jwkunz/BYU7SegBoard/AltiumFiles/Board Picture.PNG

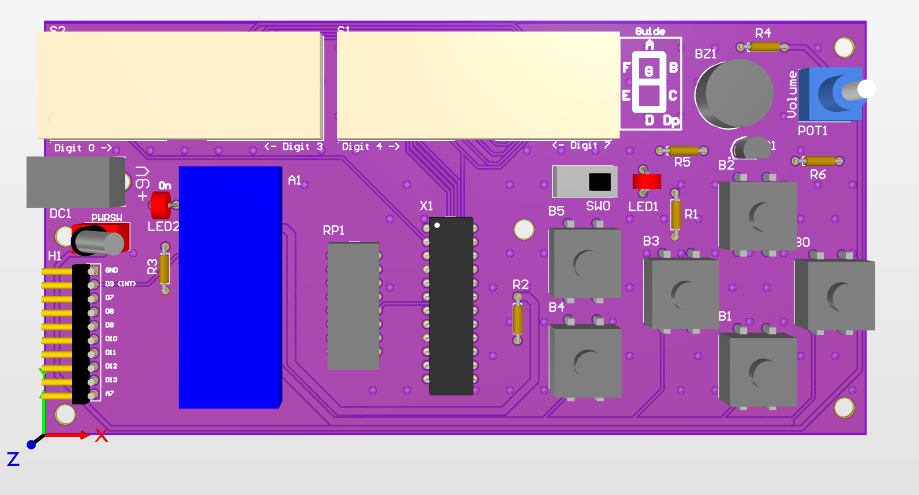
AltiumFiles/Board Picture.PNG
