jwkunz/BYU7SegBoard/Documentation/ArduinoInterfaceGraphic.PNG

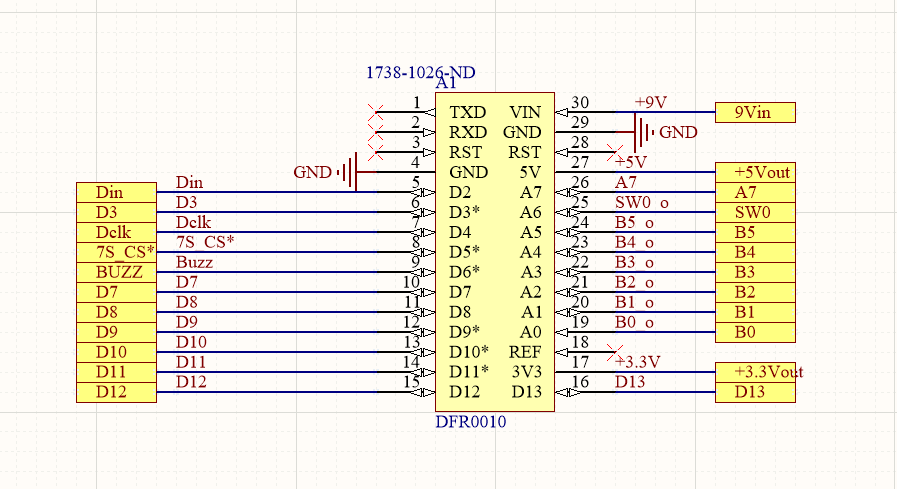
Documentation/ArduinoInterfaceGraphic.PNG
