jwkunz/BYU7SegBoard/Documentation/CostTable.pdf

### Seven Segment Board

Price Break | | Purchased For August 8th Activity
Component | Vendor | | 1 | 3 | 6 | 10 | 50 | 100 | 4
Fabrication | OSH PARK | 97.95 $ | 97.95 $ | 182.50 $ | 182.50 $ | 912.50 $ | 1,825.00 $ | 97.95 $ | *Given Free Board from QuickTurn
Board Parts | Mouser | 50.97 $ | 136.93 $ | 265.87 $ | 437.79 $ | 1,941.29 $ | 3,444.79 $ | 179.91 $
Arduino Nano | Amazon | 8.29 $ | 13.86 $ | 27.72 $ | 37.98 $ | 189.90 $ | 379.80 $ | 31.98 $
Shop Supplies | ECEN Shop | 2.00 $ | 2.00 $ | 2.00 $ | 4.00 $ | 6.00 $ | 10.00 $ | 2.00 $
Total | 160.21 $ | 253.74 $ | 484.09 $ | 672.27 $ | 3,099.69 $ | 5,759.59 $ | 315.84 $
Cost Per | 160.21 $ | 84.58 $ | 80.68 $ | 67.23 $ | 61.99 $ | 57.60 $ | 78.96 $
