jwkunz/BYU7SegBoard/Documentation/MouserBOM.pdf

SHOPPING CART
This is not an invoice
23-Jul-18 14:51:10
Mouser # | Mfr. # | Manufacturer | Customer # Description | RoHS | Lifecycle | Order Qty. Price (USD) | Ext.: (USD)
1 474-COM-09190 | COM-09190 | SparkFun Electronics | SparkFun Accessories Momentary Pushbutton Switch - 12mm Square RoHS Compliant | New At Mouser | 6 $0.50 | $3.00
2 810-PS1240P02BT | PS1240P02BT | TDK | Audio Indicators & Alerts Round 12.2mmx6.5mm 4kHz Vin=3V | RoHS Compliant | | 1 $0.72 | $0.72
3 490-PJ-037A | PJ-037A | CUI Inc. | DC Power Connectors Power Jacks | RoHS Compliant | | 1 $0.58 | $0.58
4 859-LTL-4223 | LTL-4223 | Lite-On | Standard LEDs - Through Hole Red Diffused | RoHS Compliant | | 2 $0.12 | $0.24
5 652-3310R-125-103L | 3310R-125-103L | Bourns | Potentiometers 9mm 10Kohms Single Cup | RoHS Compliant | | 1 $2.61 | $2.61
6 612-200-A1121 | 200MSP1T1B1M2QEH E-Switch | Toggle Switches SPDT ON-OFF-ON PCMNT | RoHS Compliant | 1 $2.23 | $2.23
7 512-2N3904BU | 2N3904BU | ON Semiconductor | Bipolar Transistors - BJT NPN Transistor General Purpose | RoHS Compliant | | 1 $0.21 | $0.21
8 603-MFR-25FBF52-9K53 MFR-25FBF52-9K53 | Yageo | Metal Film Resistors - Through Hole 9.53K OHM 1/4W 1% | RoHS Compliant | 1 $0.12 | $0.12
9 652-4116R-2LF-10K | 4116R-2-103LF | Bourns | Resistor Networks & Arrays 16pin 10Kohms Bussed Low Profile | RoHS Compliant By Exemption | | 1 $1.09 | $1.09
10 696-LDQ-N516RI | LDQ-N516RI | Lumex | LED Displays & Accessories .56" SUPER RED | RoHS Compliant | | 2 $6.73 | $13.46
11 642-SLG12014 | SLG12014 | Apem | Slide Switches SLIDE 1P2T | RoHS Compliant | | 1 $1.46 | $1.46
12 700-MAX7219CNG | MAX7219CNG+ | Maxim Integrated | LED Display Drivers 8-Digit LED Display Driver | RoHS Compliant | | 1 $9.12 | $9.12
13 474-TOL-00298 | TOL-00298 | SparkFun Electronics | SparkFun Accessories Wall Adapter Power Supply - 9VDC 650mA | | New At Mouser | 1 $5.95 | $5.95
14 603-MFR-25FRF52100R MFR-25FRF52-100R | Yageo | Metal Film Resistors - Through Hole 100ohm 1/4W 1% | RoHS Compliant By Exemption | 2 $0.12 | $0.24
15 603-MFR-25FTF52-1K | MFR-25FTF52-1K | Yageo | Metal Film Resistors - Through Hole 1/4W 1K Ohm 1% | RoHS Compliant | New Product | 2 $0.12 | $0.24
16 603-MFR-25FBF52-18R MFR-25FBF52-18R | Yageo | Metal Film Resistors - Through Hole 18 OHM 1/4W 1% | RoHS Compliant | 1 $0.12 | $0.12
17 538-90121-0768 | 90121-0768 | Molex | Headers & Wire Housings 2.54MM CGRIDIII HDR 8P R/A SR SEL AU | RoHS Compliant | | 1 $1.59 | $1.59
By submitting your order you agree to these terms and conditions. | Merchandise Total: | $42.98
Prices are reflected at the date and time shown. | Shipping Charge: | $7.99
