jwkunz/BYU7SegBoard/AltiumFiles/Project Outputs for BYU7SegBoard/BrendonsBoardBOM.xlsx

Part Number | Description | Designator | Supplier | Quantity | Total Cost | Purpose | Link
DFR0010 | DFRDUINO NANO V3.1 (ARDUINO NANO | A1 | Amazon | 1 | $4.00 | Control | https://www.amazon.com/ATmega328P-Microcontroller-Board-Cable-Arduino/dp/B00NLAMS9C?s=electronics
COM-09190 | Tactile Pushbotton | B0, B1, B2, B3, B4, B5 | Mouser | 6 | $3.00 | Buttons
PS1240P02BT | Piezo Buzzer, Through Hole | BZ1 | Mouser | 1 | $0.67 | Sound
PJ-037A | CONN PWR JACK 2X5.5MM SOLDER | DC1 | Mouser | 1 | $0.58 | Power
90121-0768 | Header 12 Right Angle 100 mil | H1 | Mouser | 1 | $0.50 | External Connections
LTL-4223 | 2 V drop 10 mA Red | LED1, LED2 | Mouser | 2 | $0.72 | Indicator Lights
3310R-125-103L | POT 10K OHM 1/4W PLASTIC LINEAR | POT1 | Mouser | 1 | $2.74 | Volume Control
200MSP1T1B1M2QEH | SWITCH TOGGLE SPDT 3A 120V | PWRSW | Mouser | 1 | $2.23 | Power Switch
2N3904BU | TRANS NPN 40V 0.2A TO-92 | Q1 | Mouser | 1 | $0.21 | Sound
MFR-25FRF52-100R | 100 | R1 | Mouser | 1 | $0.10 | Indicator
MFR-25FBF52-9K53 | 9.53k | R2 | Mouser | 1 | $0.10 | Display
MFR-25FTF52-1K | 1k | R3 | Mouser | 1 | $0.10 | Indicator
MFR-25FTF52-1K | 1k | R4 | Mouser | 1 | $0.10 | Volume
MFR-25FRF52-100R | 100 | R5 | Mouser | 1 | $0.10 | Volume
MFR-25FBF52-18R | 18 | R6 | Mouser | 1 | $0.10 | Sound
4116R-2-103LF | Resistor Pack | RP1 | Mouser | 1 | $1.16 | Control
LDQ-N516RI | LED 7-SEG .56 QUAD S-RED CC MULT | S1, S2 | Mouser | 2 | $13.46 | Display (1 Minimum)
SLG12014 | SWITCH SLIDE SPDT 300MA 125V | SW0 | Mouser | 1 | $1.34 | I/O Switch
MAX7219CNG+ | Serially Interfaced, 8-Digit LED Display Driver | X1 | Mouser | 1 | $8.93 | Display
RM3X10MM 2701 | M3 Machine Screws |  | Mouser | 5 | $2.70 | Mounting
 | Breadboad Wire |  | ECEN SHOP |  | $0.50 | Bypassing Parts Extra Parts
TOL-00298 | AC/DC WALL MOUNT ADAPTER 9V 650 mA |  | Mouser | 1 | $5.95 | Power
 |  |  |  | Total | $49.29
OSH PARK FAB |  |  | OSH PARK |  | $33.00
 |  |  |  |  | $82.29
 |  |  |  | Total | $82.29
 |  |  |  |  | Basic
