jwkunz/BYU7SegBoard/AltiumFiles/BYU7SegBoard.pdf

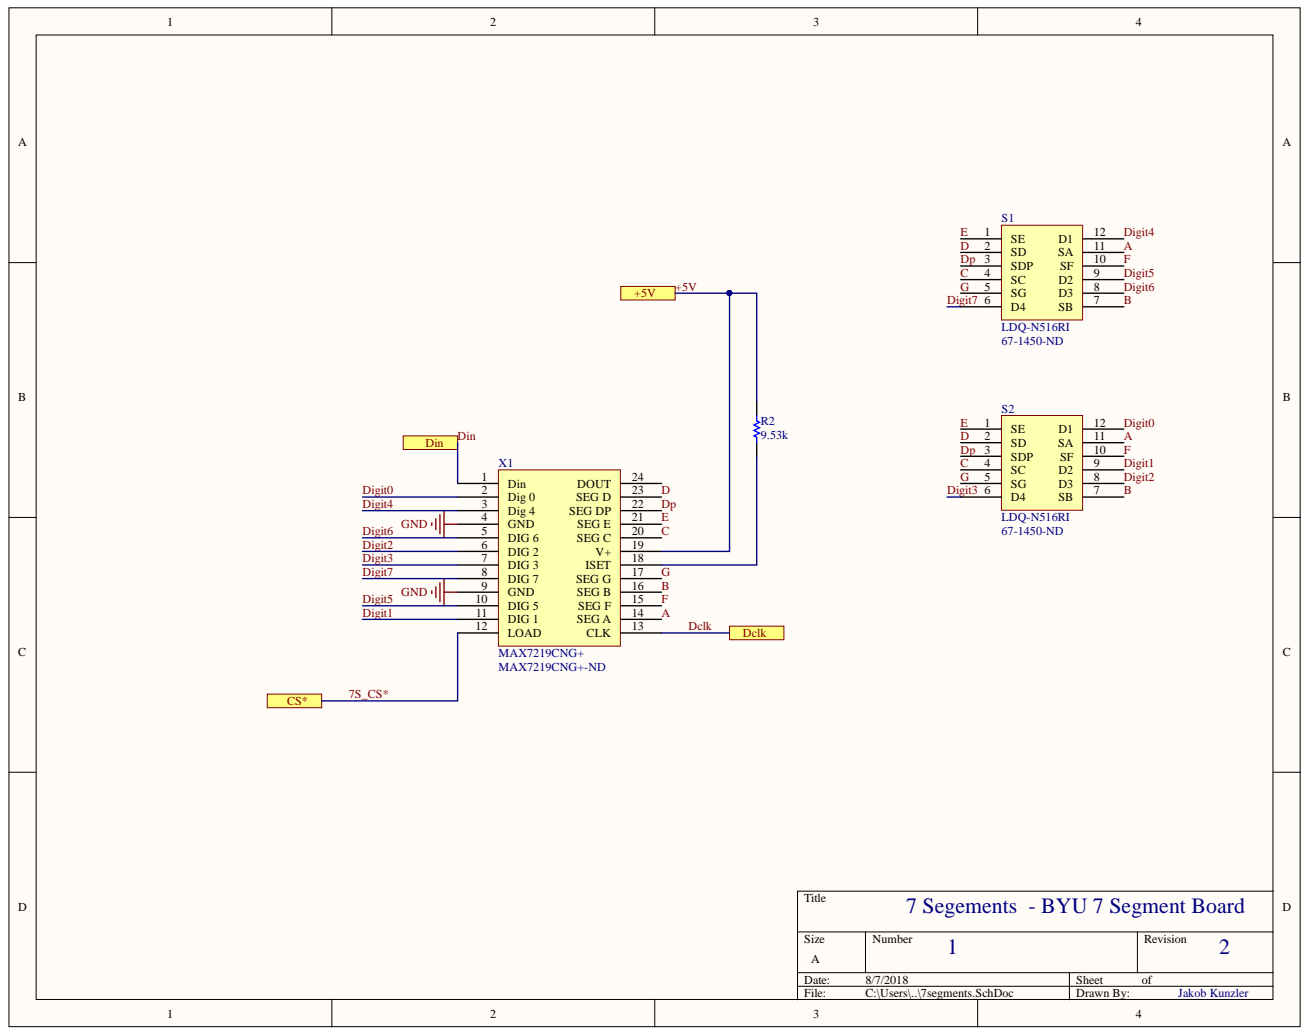
[picture p3: page 1]
Title; Size; Number; Revision; Date:; Sheet; File:; C:\Users\..\7segments.SchDoc; Drawn By:; MAX7219CNG+-ND; Din 1 Dig 0 2 Dig 4 3 GND 4 DIG 6 5 DIG 2 6 DIG 3 7 DIG 7 8 GND 9 DIG 5 10 DIG 1 11; LOAD 12; CLK; 13 SEG A; 14 SEG F; 15 SEG B; 16 SEG G; 17 ISET; 19 SEG C; 20 SEG E; 21 SEG DP; 22 SEG D; 23 DOUT; MAX7219CNG+; Din; Dclk; Digit1; Digit5; Digit7; Digit3; Digit2; Digit6; Digit4; Digit0; GND; SE 1 SD 2 SDP 3 SC 4 SG 5; LDQ-N516RI; A F Digit5 Digit6; A F Digit1 Digit2; Jakob Kunzler

7 Segements - BYU 7 Segment Board

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
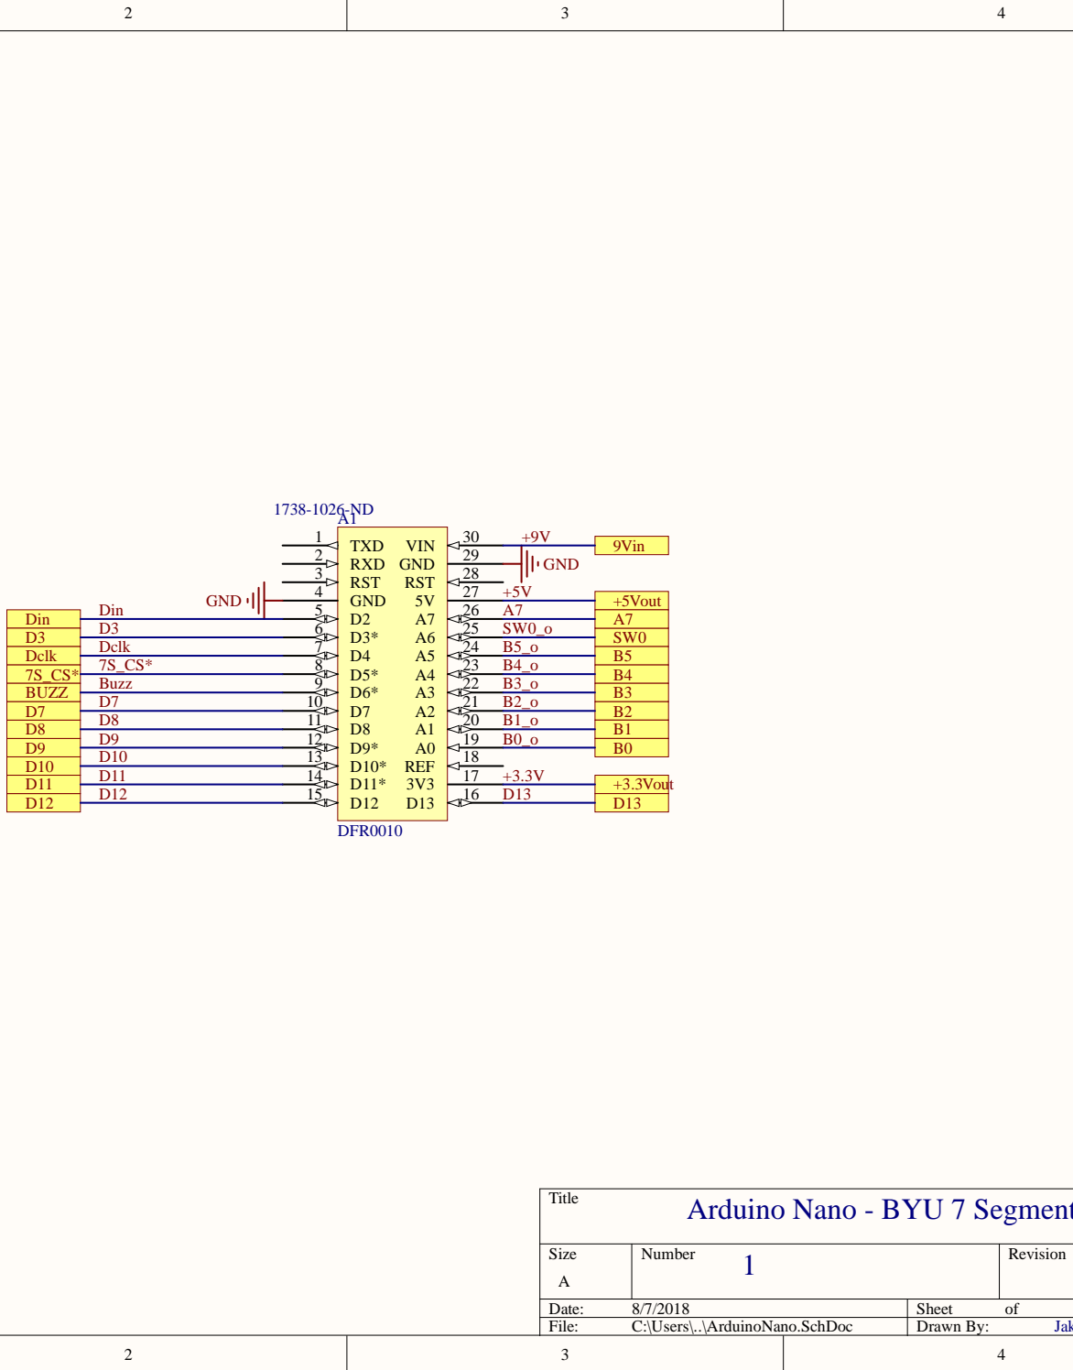
[picture p4: figure]
Numbe; Revi; ion; ADat; She; ers; ArduinoN; ano.; chDoc; Dra; Buz; +3.3Vout; +5Vout A7; PIA101 PIA102 PIA103 PIA104 PIA105 PIA106 PIA107 PIA108 PIA109 PIA1010 PIA1011 PIA1012 PIA1013; PIA1014; PIA1015; PIA1016; PIA1017; PIA1018; PIA1019; PIA1020; PIA1021; PIA1022; PIA1023; PIA1024; PIA1025; PIA1026; PIA1027; PIA1028; PIA1029; PIA1030; COA1; PO0303Vout; PO05Vout; PO9Vin; POA7; POB0; POB1; POB2; POB3; POB4; POB5; POBUZZ; POD3; POD7 POD8 POD9 POD10 POD11; POD12; POD13; PODclk; PODin; POSW0

D13 | 16 3V3 | 17 REF | 18 A0 | 19 A1 | 20 A2 | 21 A3 | 22 A4 | 23 A5 | 24 A6 | 25 A7 | 26 5V | 27 RST | 28 GND | 29 VIN | 30
Arduino Nano - BYU 7 Segment Board 1 | 2 Jakob Kunzler

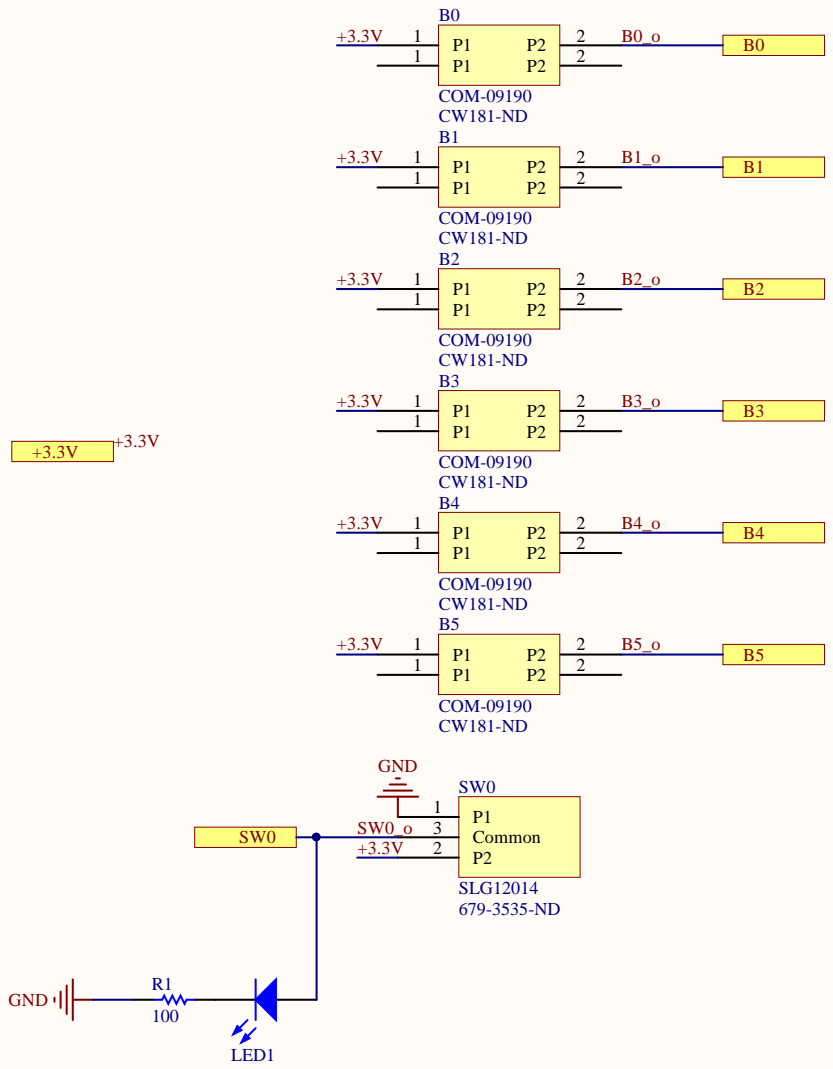
[picture p5: page 3]
Size; Number; Revision; File:; C:\Users\..\ButtonAndSwitches.SchDoc; Drawn By:; Common 3; SLG12014; GND; LED1; COM-09190

Title
Buttons and Switches - BYU 7 Segment Board

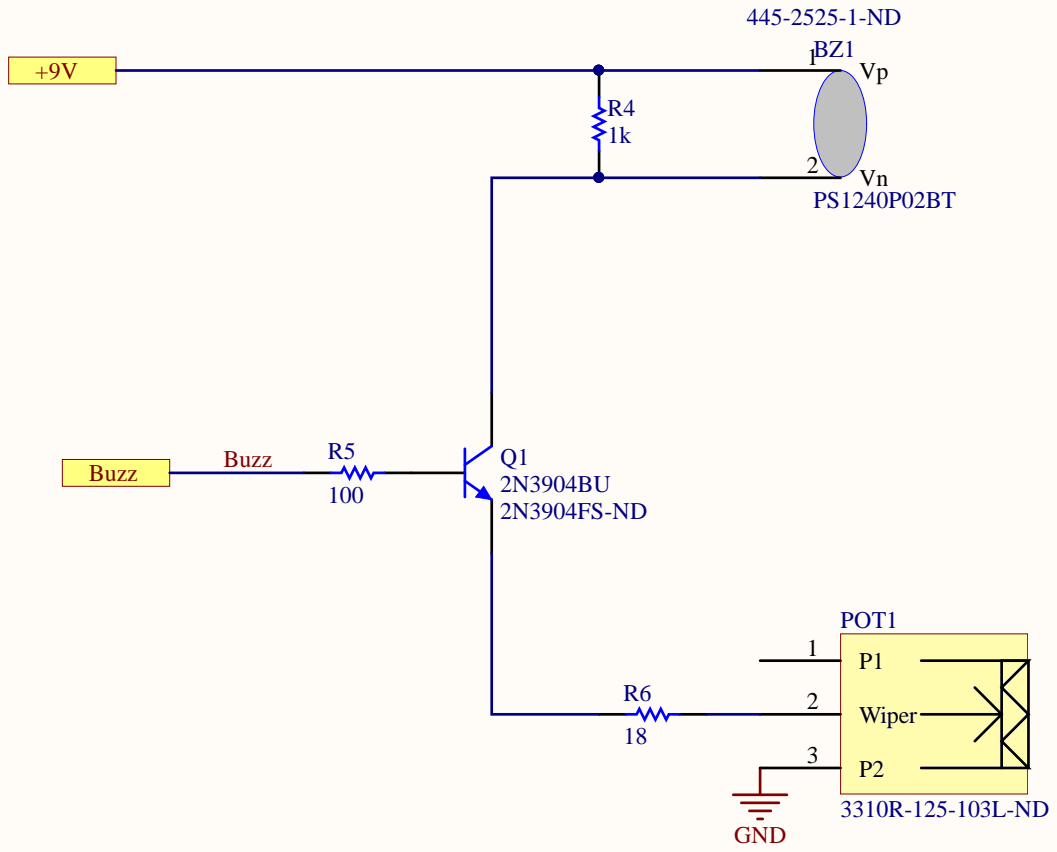
[picture p6: page 4]
Title; Size; Number; Revision; File:; C:\Users\..\Sound.SchDoc; Drawn By:; GND; Wiper 2; POT1; Buzz

Sound - BYU 7 Segment Board

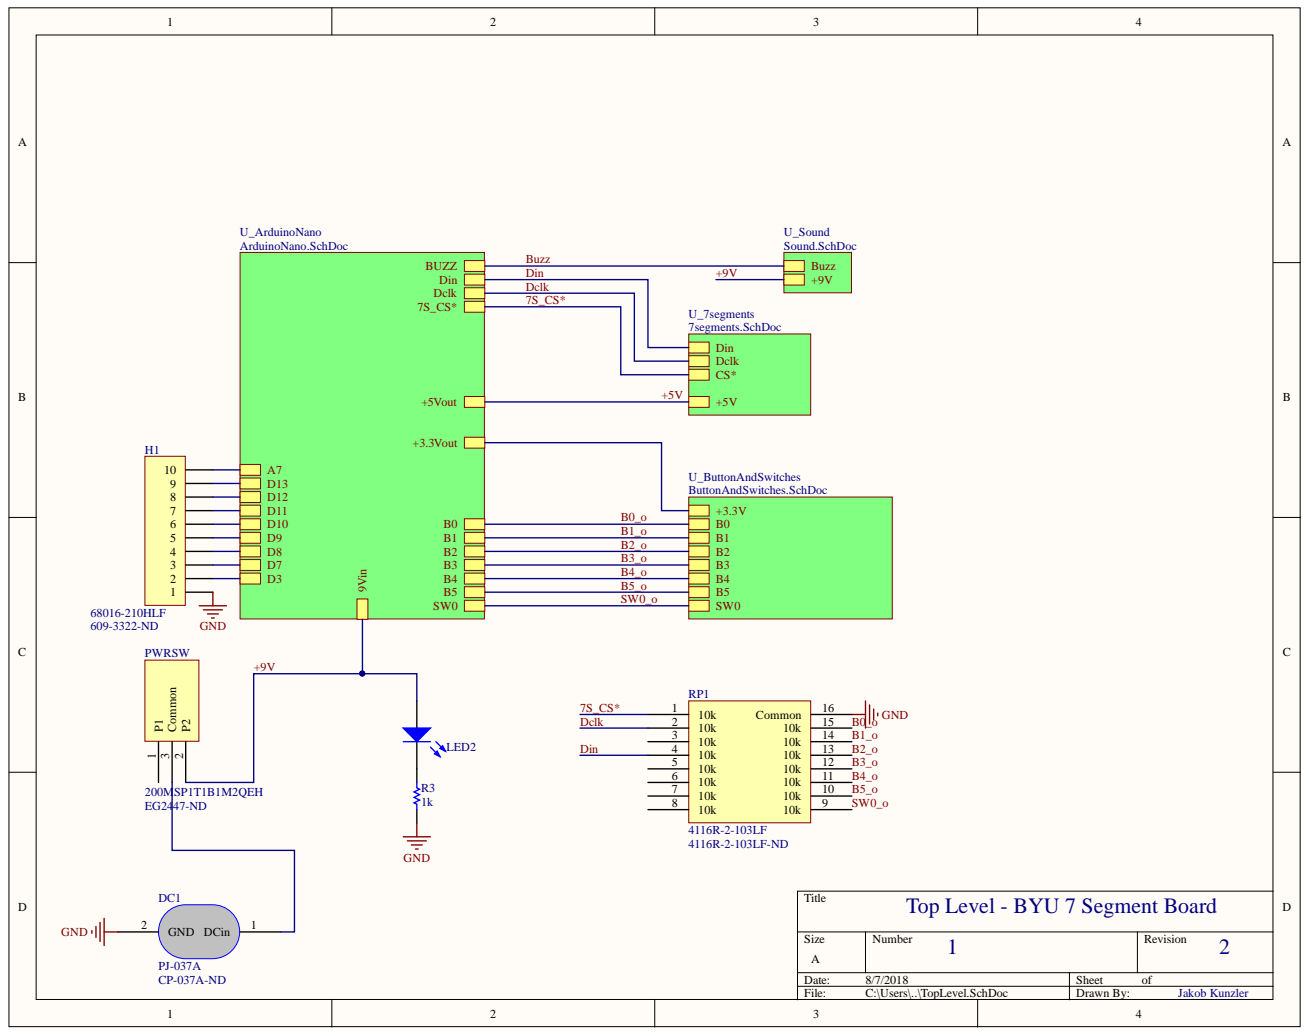
[picture p7: page 5]

Top Level - BYU 7 Segment Board

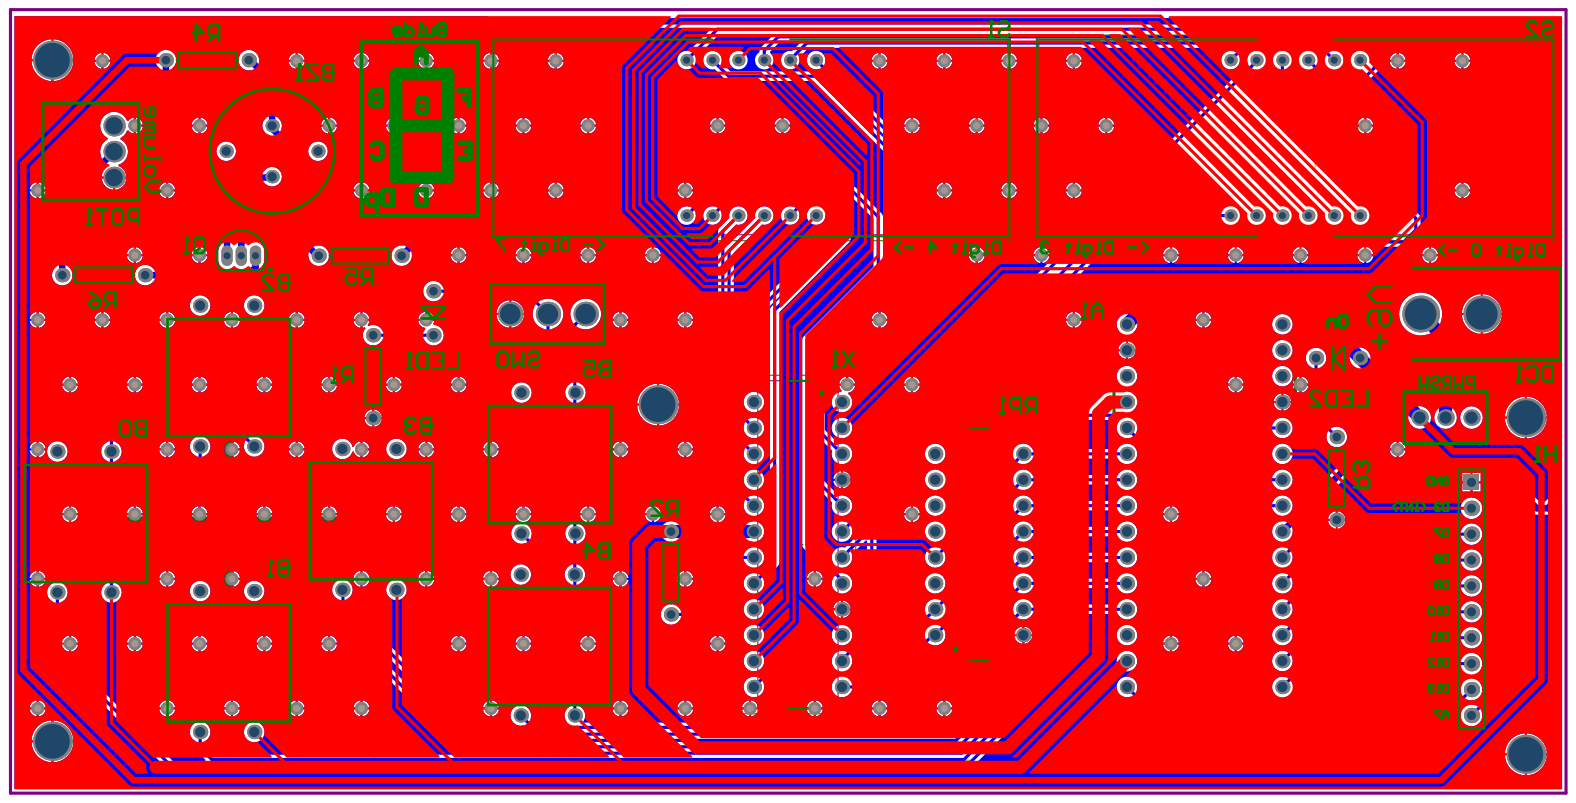
[picture p8: page 6]
Jakob Kunzler

Phased Array Research

Nano User Interface Board V2

Component list | Bill of Materials For Project [BYU7SegBoard.PrjPCB] (No PCB Document Selected)
Source Data From: | BYU7SegBoard.PrjPCB
Project: | | BYU7SegBoard.PrjPCB
Variant: | | None
Report Date: | 8/7/2018 | 8:25:32 AM
Print Date: | 07-Aug-18 | 8:25:40 AM
Description | Footprint | Quantitny Name E | Designator #Column Name Error:Manufacture#rCo lumn Name Error:Manufactur#eCor1lu PmNn Name Error:Unit# PColumn Name Error:Manufacture#rCo lumn Name Error:Manufactur#eCor2lu PmNn Name Error:Unit P | | Total Price ($)
DFRDUINO NANO V3.1 (ARDUINO NANO | ArduinoNano | 1 | A1 | | 0
Momentary Pushbutton Sw itch - 12mm Square | COM-09190 | 6 | B0, B1, B2, B3, B4, B5 | | 0
Piezo Buzzer, Through Hole | PS1240P02BT | 1 | BZ1 | | 0
CONN PWR JACK 2X5.5MM SOLDER | PJ-037A | 1 | DC1 | | 0
Header 10 Right Angle 100 mil | Header1X10 | 1 | H1 | | 0
2 V drop 10 mA Red | LED Through | 2 | LED1, LED2 | | 0
POT 10K OHM 1/4W PLASTIC LINEAR | 3310R-001 | 1 | POT1 | | 0
SWITCH TOGGLE SPDT 3A 120V | 200MSP1T1B1M2QEH | 1 | PWRSW | | 0
TRANS NPN 40V 0.2A TO-92 | 2N3904 | 1 | Q1 | | 0
CF14JT100R | Resistor Through Hole | 2 | R1, R5 | | 0
MFR-25FBF52-9K53 | Resistor Through Hole | 1 | R2 | | 0
CF14JT1K00 | Resistor Through Hole | 2 | R3, R4 | | 0
CF14JT18R0 | Resistor Through Hole | 1 | R6 | | 0
| 4100R | 1 | RP1 | | 0
LED 7-SEG .56 QUAD S-RED CC MULT | LDQ-516RI | 2 | S1, S2 | | 0
SWITCH SLIDE SPDT 300MA 125V | SLG12014 | 1 | SW0 | | 0
Serially Interfaced, 8-Digit LED Display Driver | MAX7219 | 1 | X1 | | 0
| | | | TOTAL PRICE | 0.000

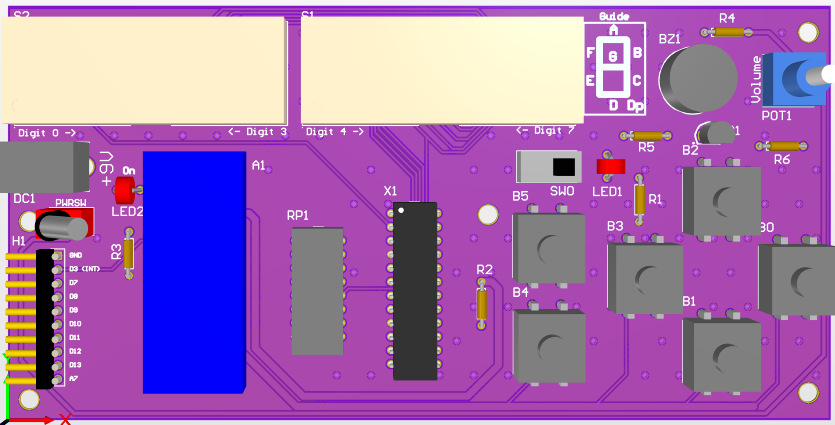
[picture p9: page 8]
