jwkunz/BYU7SegBoard/Documentation/LDQ-N516RI.pdf

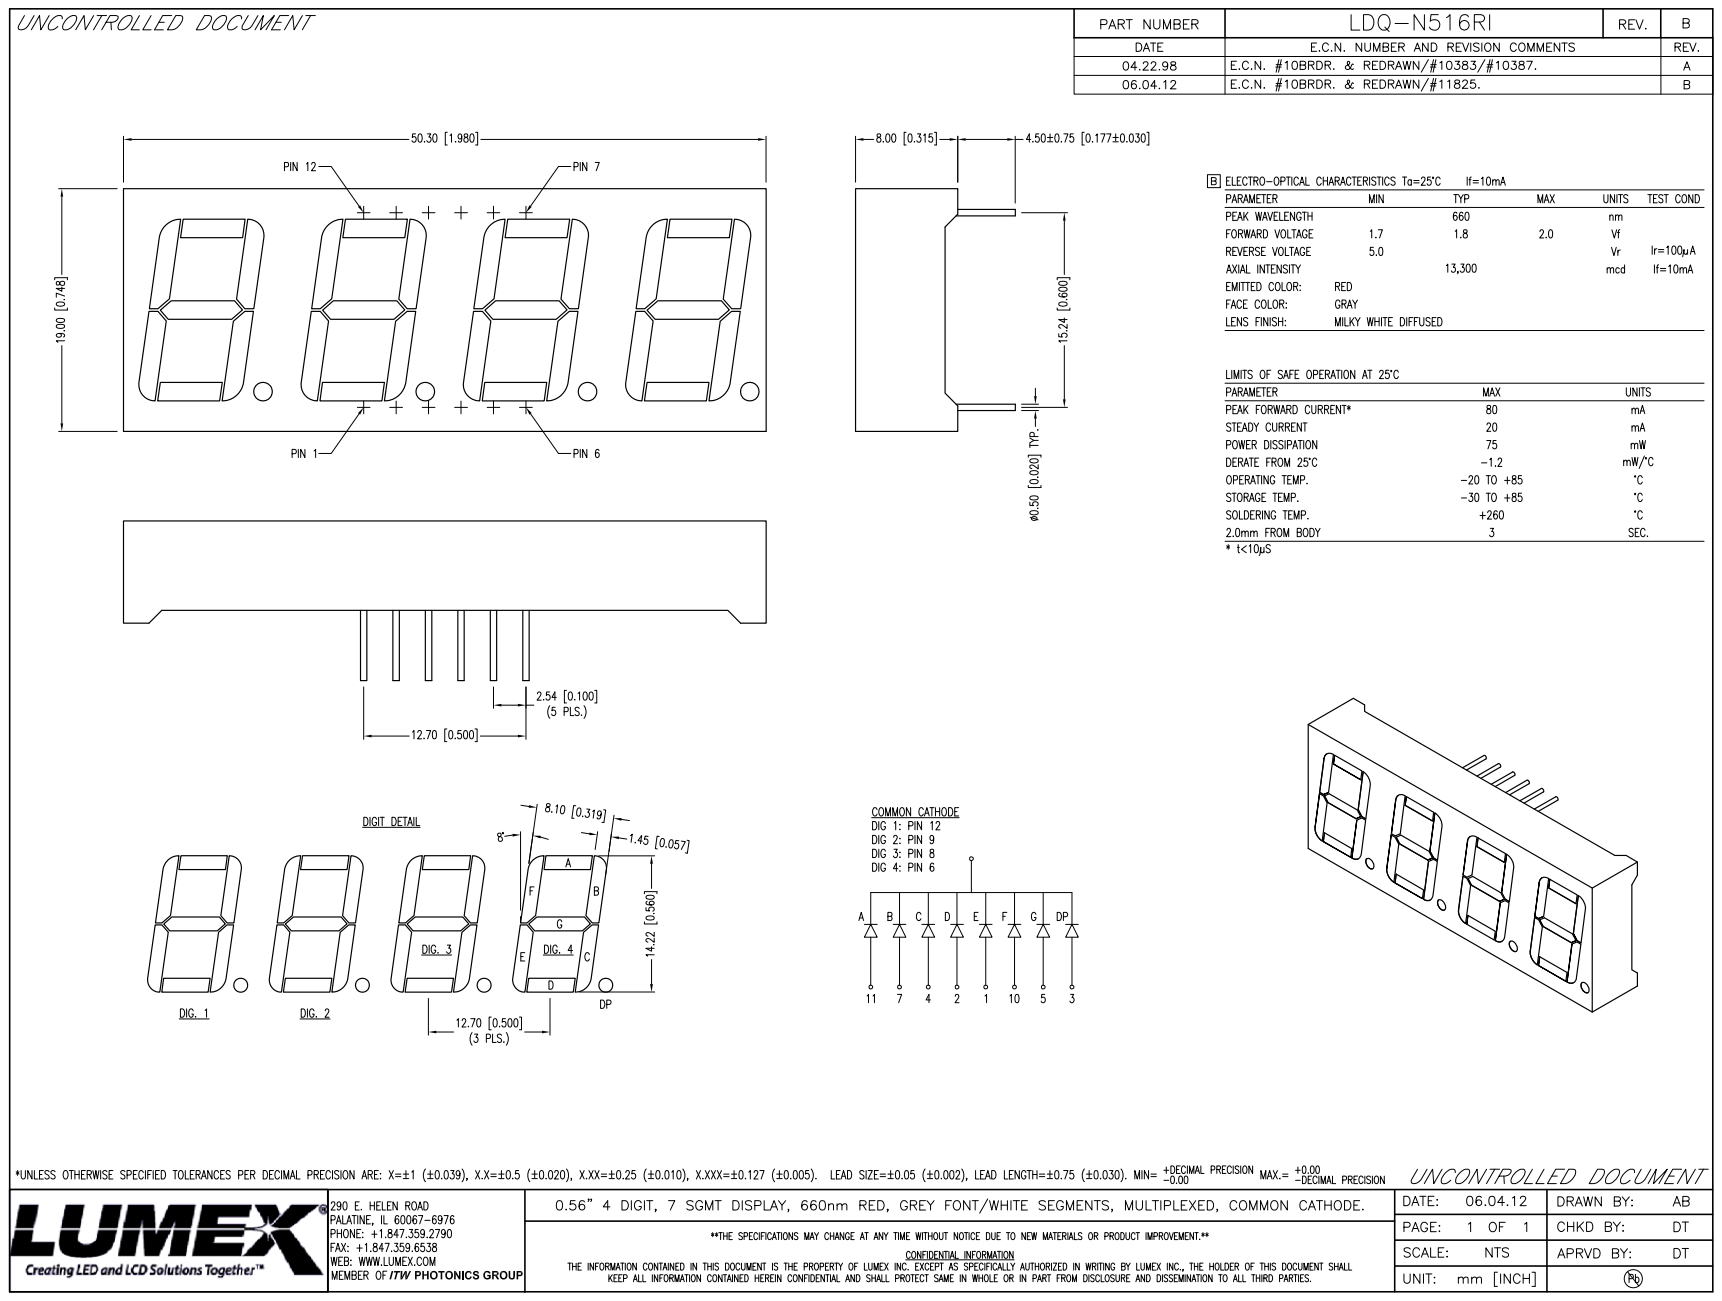
[picture p10: page 1]
