jwkunz/BYU7SegBoard/LT Spice/Buzzer.asc

L1: ind; 1E-6
Q1: npn; 2N3904
R1: res; 100
R2: res; 1E3
R3: res; 10E3
R4: res; 18
V1: voltage; PULSE(0 3.3 1E-6 1E-9 1E-9 1E-6 2E-6 20)
V2: voltage; 9
Named nets: 0
.tran 0 10E-6 1E-6
