jwkunz/BYU7SegBoard/(list of files, drawings)

Other design files:
AltiumFiles/7segments.SchDoc
AltiumFiles/ArduinoNano.SchDoc
AltiumFiles/ButtonAndSwitches.SchDoc
AltiumFiles/BYU7SegBoard.PcbDoc
AltiumFiles/BYU7SegBoard.PcbLib
AltiumFiles/BYU7SegBoard.PrjPCB
AltiumFiles/BYU7SegBoard.SchLib
AltiumFiles/ServoInterface.PrjPCB
AltiumFiles/Sound.SchDoc
AltiumFiles/TopLevel.SchDoc
LearningActivity/7segments.SchDoc
LearningActivity/ArduinoNano.SchDoc
LearningActivity/blankPCB.PcbDoc
LearningActivity/ButtonAndSwitches.SchDoc
LearningActivity/Sound.SchDoc
LearningActivity/TopLevel.SchDoc
