jwkunz/BYU7SegBoard/(commit log)

2018-07-06 Basic Clock (untested)
    Could run a basic clock without a buzzer. The seven segment needs expanded character suppourt.
    [ArduinoStdInt.h, max7221Driver.h, timeClock.h]
2018-07-06 Alphabet Added
    [max7221CharCodes.xls]
2018-07-07 Button Handler Added
2018-07-10 Added Altium Files
    [7segments.SchDoc, ArduinoNano.SchDoc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]
2018-07-10 Change to the board from assembly expierence
    [7segments.SchDoc, ArduinoNano.SchDoc, ButtonAndSwitches.SchDoc, ServoInterface.PcbDoc, ServoInterface.PcbLib, ServoInterface.PrjPCB, ServoInterface.SchLib, Sound.SchDoc]
2018-07-11 Added the ISR
    [ServoInterface.PcbDoc]
2018-07-14 Ticking Clock on 7 Segment!
    [max7221CharCodes.xls]
2018-07-15 Clock is set-able
    [max7221CharCodes.xls]
2018-07-17 TimerOne implementation. Tunned empiracally
2018-07-18 Updated BOM
    [BrendonsBoardBOM.xlsx, ServoInterfaceBOM.xlsx]
2018-07-18 PCB Buttons Updated
    [ButtonAndSwitches.SchDoc, ServoInterface.PcbDoc, ServoInterface.PcbLib, ServoInterface.PrjPCB, ServoInterface.SchLib]
2018-07-19 Fixed code couruption problem in buzzerDriver with song
    [buzzerDriver.cpp, globalParameters.h, userInterface.h]
2018-08-02 Updated Naming and File System
    [7segments.SchDoc, ArduinoNano.SchDoc, BYU7SegBoard.PcbDoc, BYU7SegBoard.PcbLib, BYU7SegBoard.PrjPCB, BYU7SegBoard.SchLib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]
2018-08-03 Patch Bug in Rev Time
    [timeClock.cpp, timeClock.h]
2018-08-03 Update to buttons, making easier to sense any pressing with if()
2018-08-06 Fixed Song. Verified performance.
    [buzzerDriver.cpp, buzzerDriver.h]
2018-08-07 Learning Activity Docs
    [7segments.SchDoc, ArduinoNano.SchDoc, BYU7SegBoard.PrjPCB, ButtonAndSwitches.SchDoc, Sound.SchDoc, TopLevel.SchDoc, blankPCB.PcbDoc]
